WaterScope-Org/hardware/Filtration Set/Cap.step

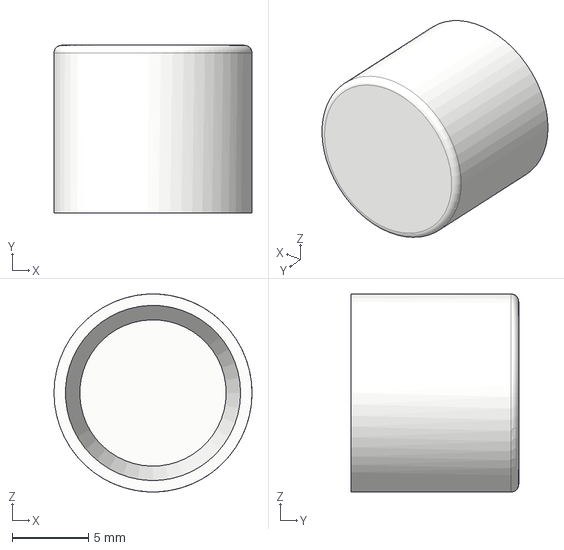
[picture p5: CAD file, 2023-12-29]
Filtration Set/Cap.step
13.0 x 11.0 x 13.0 mm
