WaterScope-Org/hardware/Incubator/incubator_bottle.step

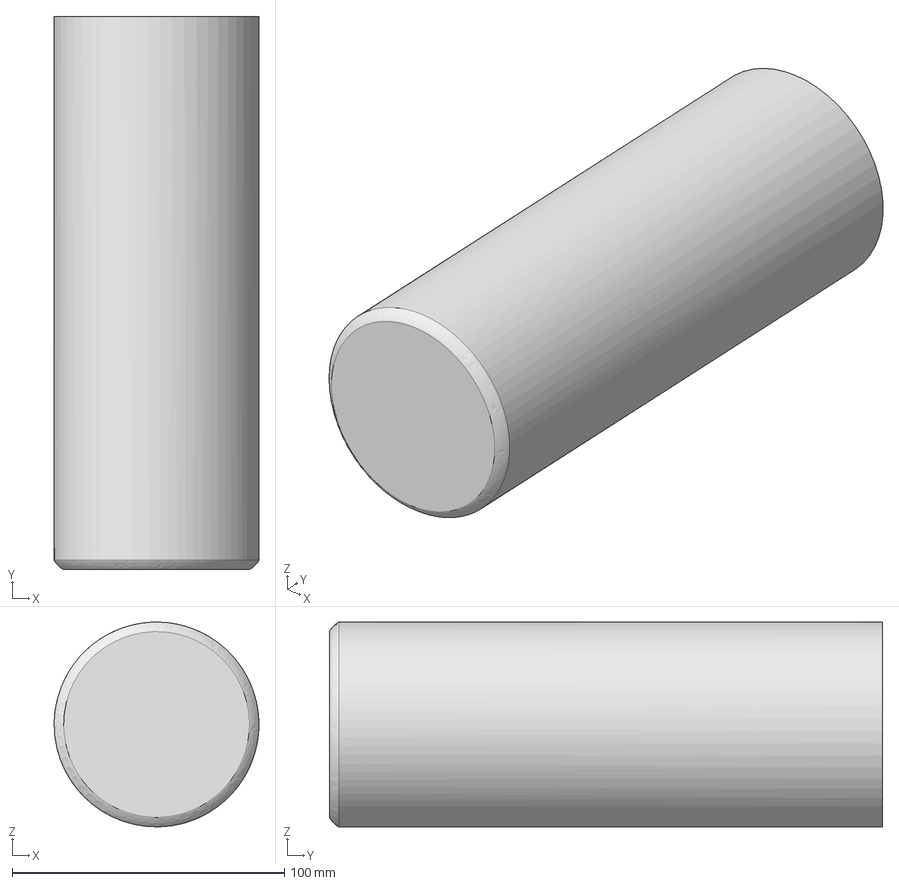
[picture p6: CAD file, 2023-12-29]
Incubator/incubator_bottle.step
75.2 x 203.0 x 75.2 mm
