WaterScope-Org/hardware/Optics Module/lid.step

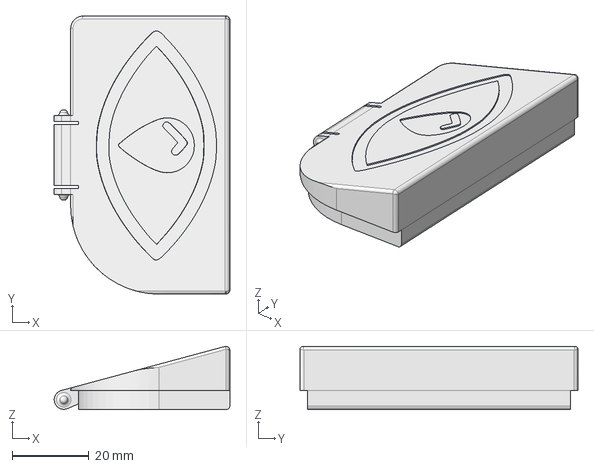
[picture p7: CAD file, 2023-12-29]
Optics Module/lid.step
45.8 x 72.5 x 16.5 mm
