WaterScope-Org/hardware/Pump/pump_left_side.step

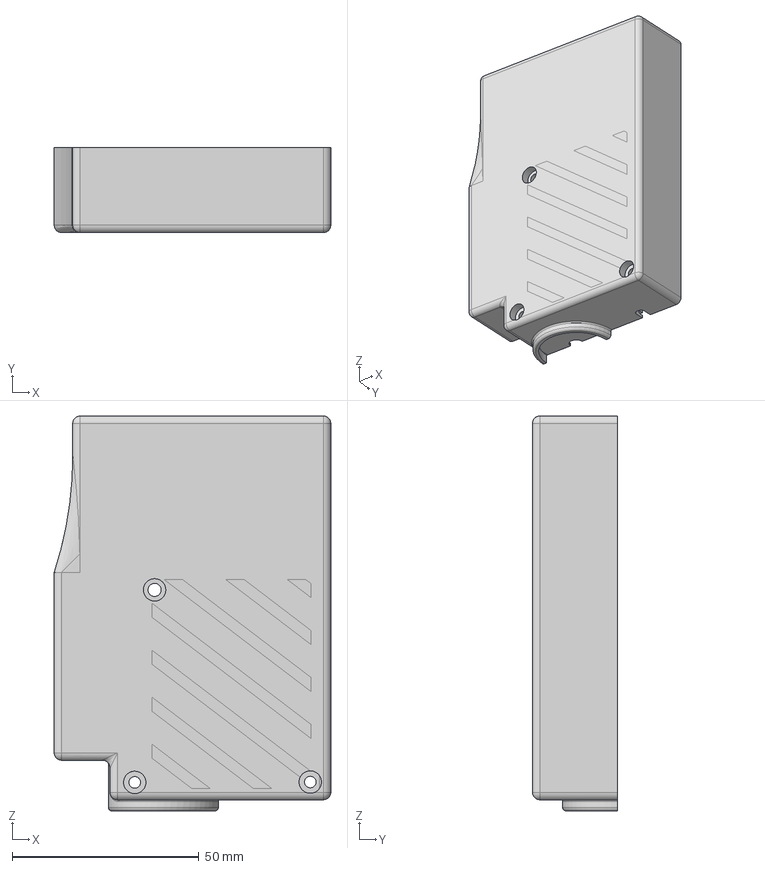
[picture p8: CAD file, 2023-12-29]
Pump/pump_left_side.step
74.1 x 22.8 x 105.7 mm
