WaterScope-Org/hardware/UVC Steriliser/uvc_lid.step

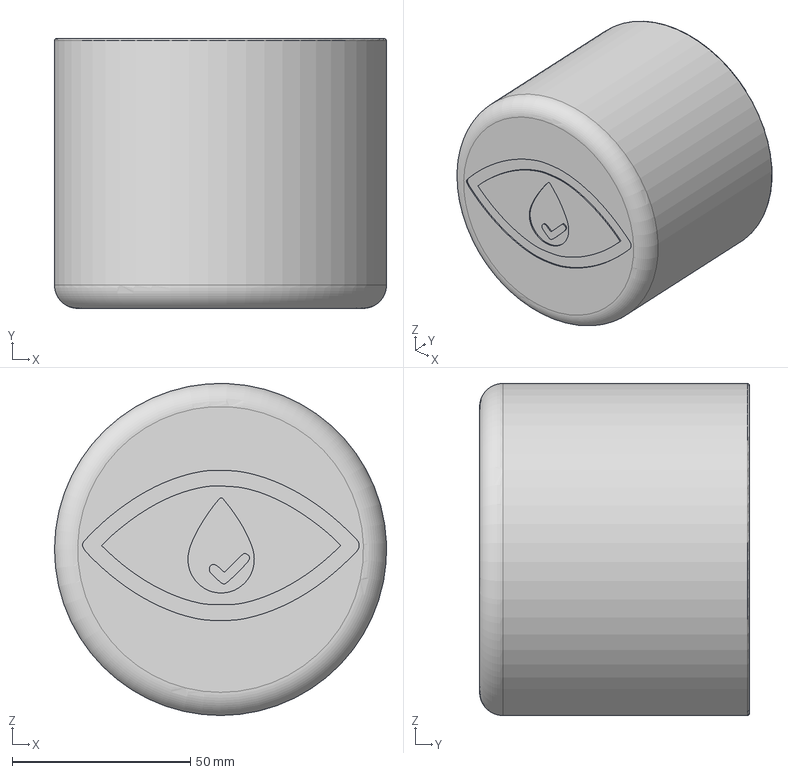
[picture p9: CAD file, 2023-12-29]
UVC Steriliser/uvc_lid.step
93.2 x 75.7 x 93.2 mm
