WaterScope-Org/hardware/Filtration Set/Collection Vessel.step

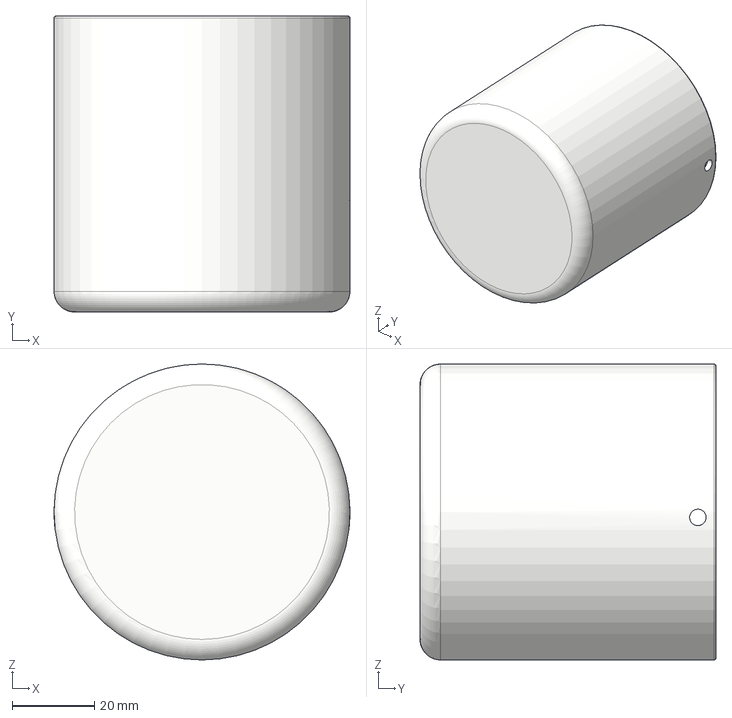
[picture p10: CAD file, 2023-12-29]
Filtration Set/Collection Vessel.step
72.0 x 72.0 x 72.0 mm
