WaterScope-Org/hardware/Incubator/cable_guide.step

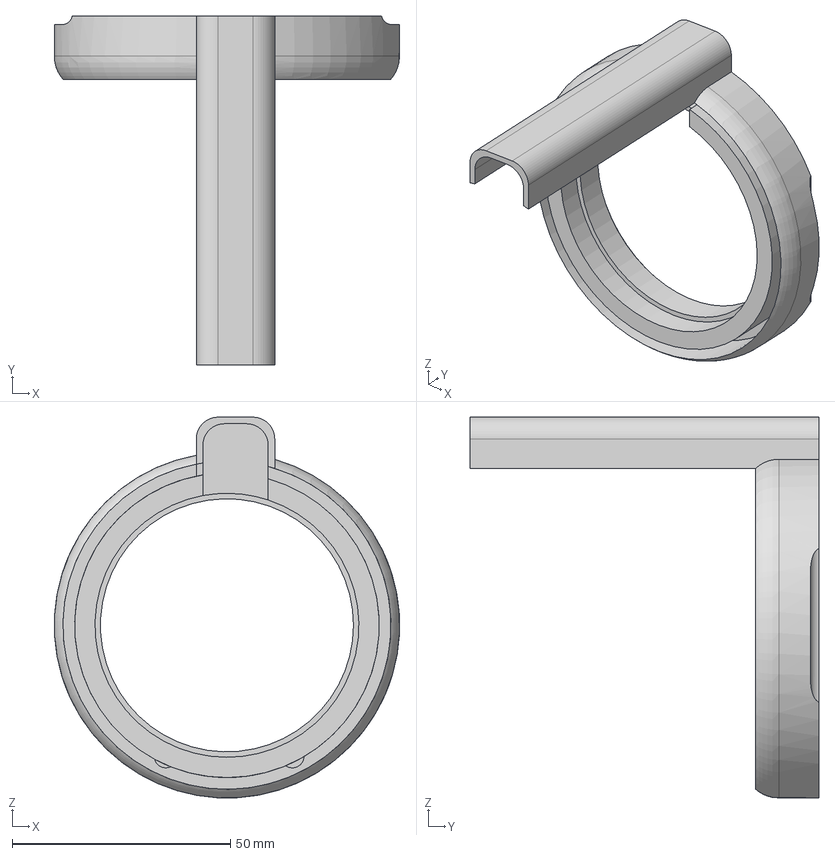
[picture p11: CAD file, 2023-12-29]
Incubator/cable_guide.step
79.1 x 80.0 x 87.3 mm
