WaterScope-Org/hardware/Optics Module/camera_rpi_holder.step

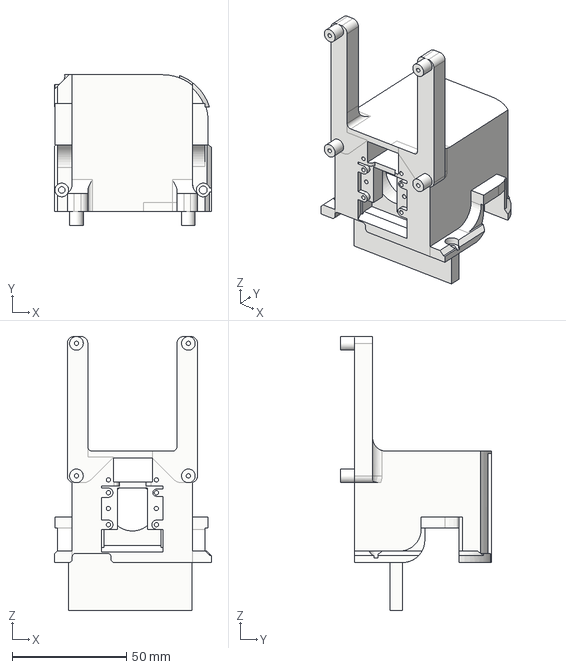
[picture p12: CAD file, 2023-12-29]
Optics Module/camera_rpi_holder.step
68.8 x 66.0 x 119.9 mm
