WaterScope-Org/hardware/Pump/pump_right_side.step

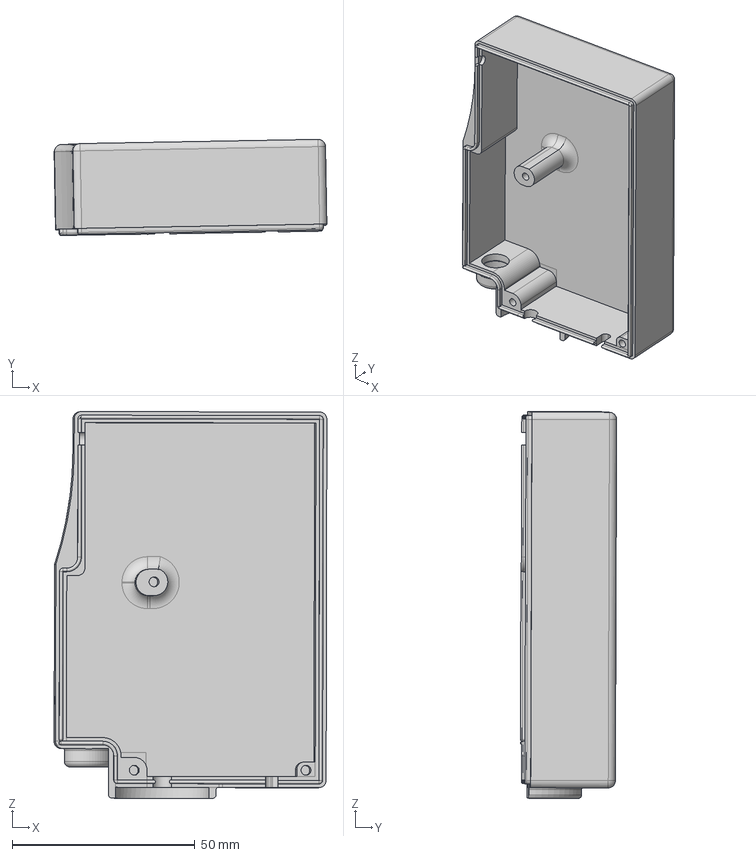
[picture p13: CAD file, 2023-12-29]
Pump/pump_right_side.step
74.6 x 26.3 x 105.8 mm
