WaterScope-Org/hardware/UVC Steriliser/uvc_bottom_part.step

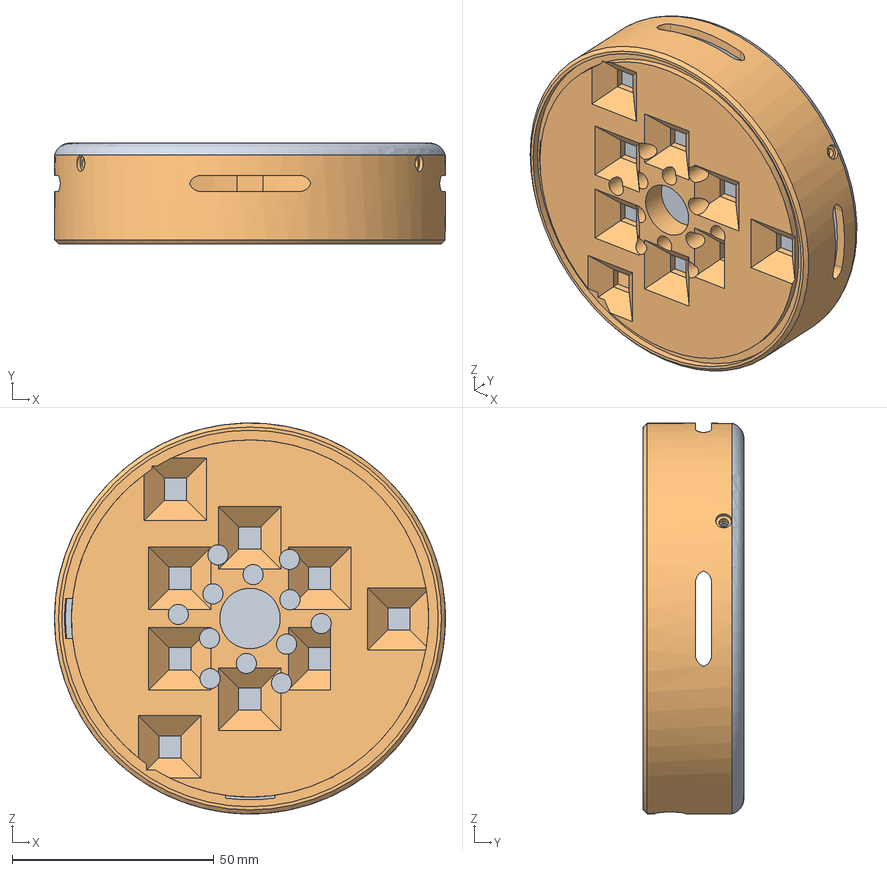
[picture p14: CAD file, 2023-12-29]
UVC Steriliser/uvc_bottom_part.step
97.0 x 25.0 x 97.0 mm
