WaterScope-Org/hardware/Filtration Set/Vacuum_cup_inner.step

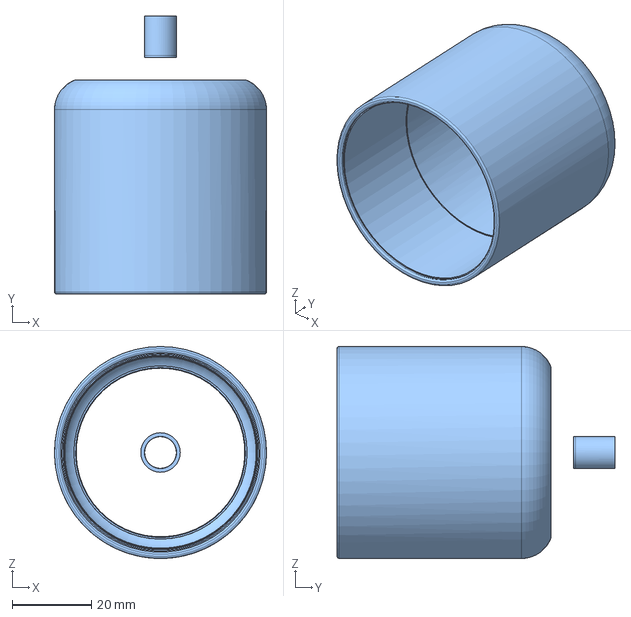
[picture p15: CAD file, 2023-12-29]
Filtration Set/Vacuum_cup_inner.step
53.6 x 70.3 x 53.6 mm
