WaterScope-Org/hardware/Incubator/cartridge_rack.step

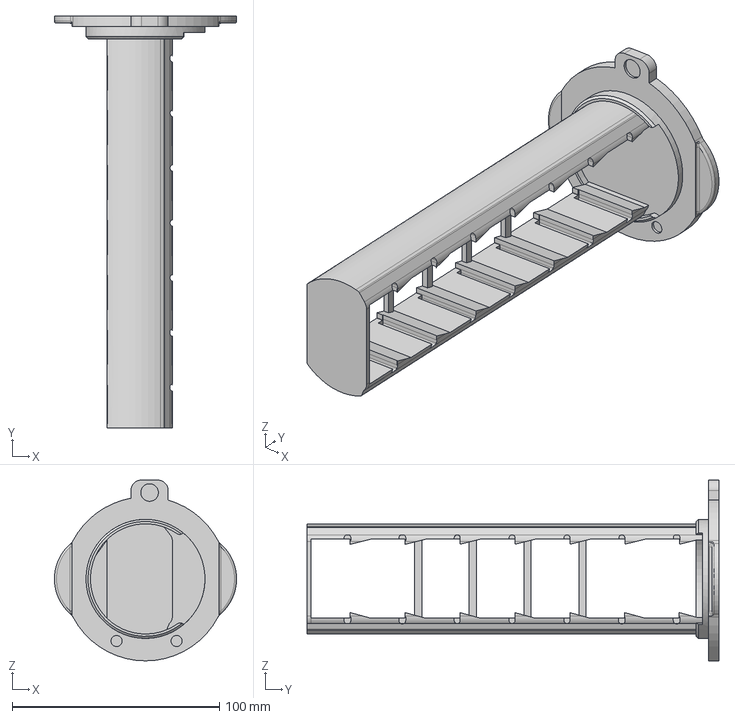
[picture p16: CAD file, 2023-12-29]
Incubator/cartridge_rack.step
88.0 x 199.0 x 87.3 mm
