WaterScope-Org/hardware/Optics Module/screen_holder.step

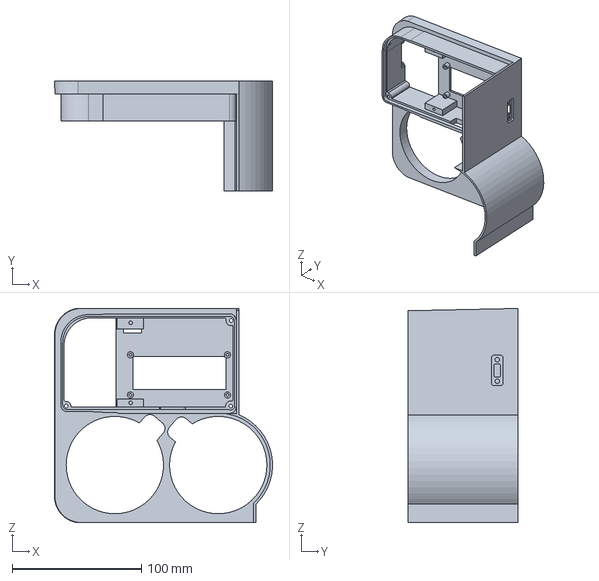
[picture p17: CAD file, 2023-12-29]
Optics Module/screen_holder.step
168.5 x 85.0 x 165.7 mm
