WaterScope-Org/hardware/Filtration Set/Vacuum_cup_outer.step

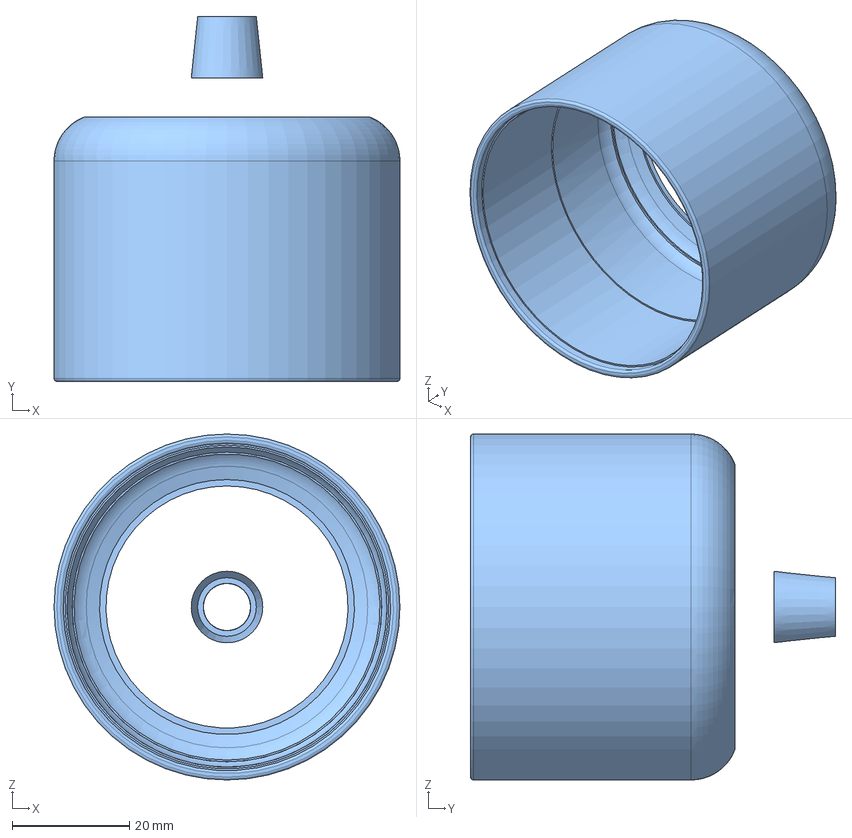
[picture p18: CAD file, 2023-12-29]
Filtration Set/Vacuum_cup_outer.step
59.0 x 62.3 x 59.0 mm
