WaterScope-Org/hardware/Optics Module/base.step

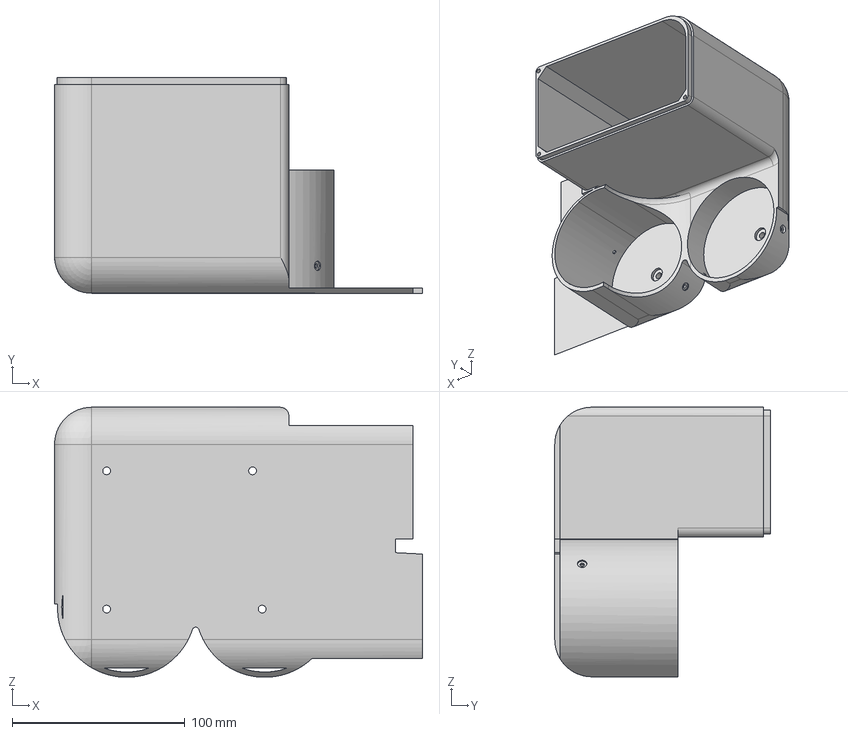
[picture p19: CAD file, 2023-12-29]
Optics Module/base.step
213.0 x 124.8 x 156.0 mm
