WaterScope-Org/hardware/Filtration Set/Base_Cup.step

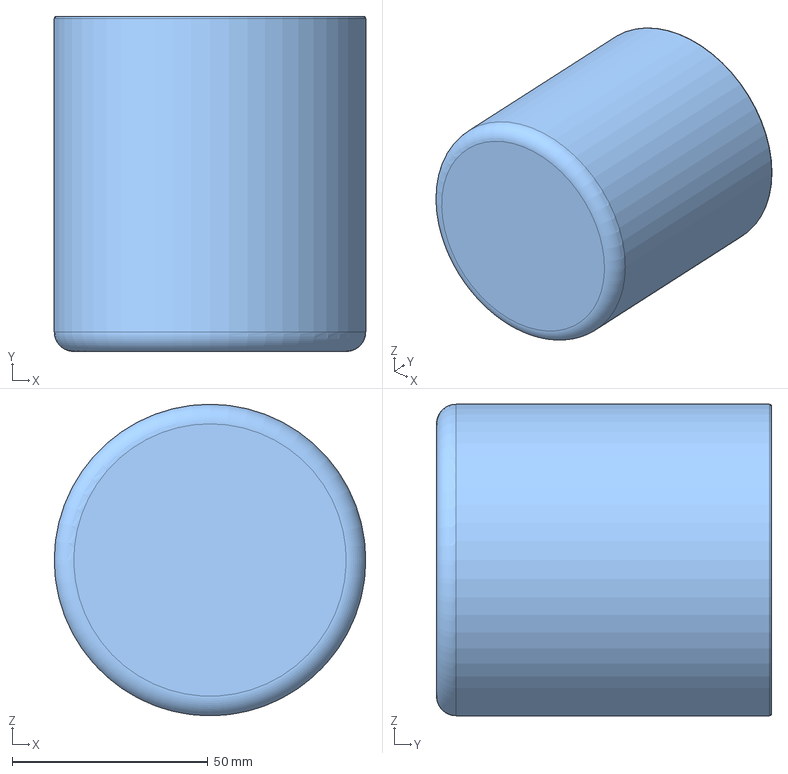
[picture p20: CAD file, 2023-12-29]
Filtration Set/Base_Cup.step
79.6 x 85.6 x 79.6 mm
