WaterScope-Org/hardware/Filtration Set/Top_part.step

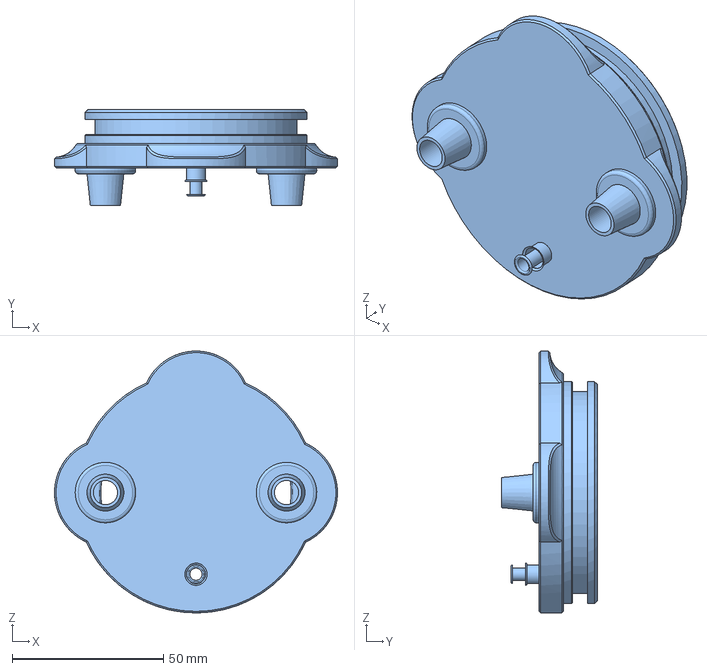
[picture p21: CAD file, 2023-12-29]
Filtration Set/Top_part.step
93.6 x 31.8 x 86.6 mm
